adamvirovecz/kicad-component-library/README.md

# KiCad Component Library

This repository contains the custom KiCad components used in my projects. The 3D models are not uploaded because I used models made by manufacturers and I do not own the rights to share them.
