adamvirovecz/kicad-component-library/(commit log)

2023-07-16 Added new library items: Nixie IN-8, Samtec ESW, TSW 1x06 connectors.
2023-08-06 Added new library items: Samtec TSS, SSW, Phoenix PTSM, Wurth LED, Microchip Logic. Fixed IN-8-2 footprint. Added Nixie Colon Tube. Added Nixie 3d models. Deleted .bak files from symbols.
2023-09-28 Many new symbols and footprints added. Some symbol libraries have been renamed to '_Custom' ending. As a general rule the symbols won't be placed to manufacturer specific libraries from now on.
2026-09-27 New symbols and footprints added. Corrected some footprint namings.
